NicholasAntoniadesEngineer/ventilator-control-system-prototype/Pictures and Videos/Ventilator demonstrator assembly.jpg

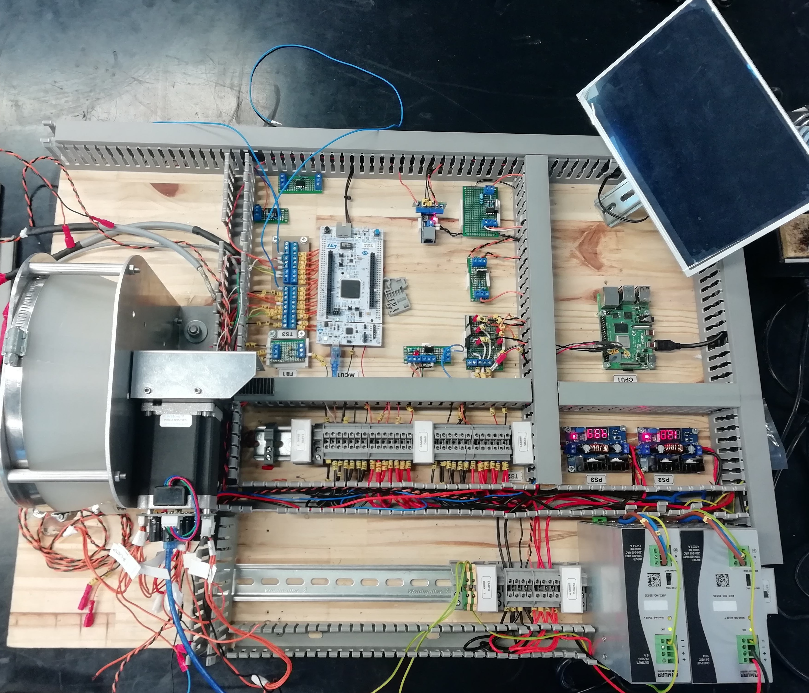
Pictures and Videos/Ventilator demonstrator assembly.jpg
