NicholasAntoniadesEngineer/ventilator-control-system-prototype/ventilator_cpap/CPAP Prototype BOM.xlsx

Item | Quantity | Brand | Supplier | Price per item | Part Number
Power
Double pole isolator | 1 | Schneider Electric | RS components | R 530.10 | A9S65240
PSU, 12v, 8.5A | 1 | Mean Well | RS components | R 398.85 | LRS-100-12
Buck Converter, 1.2v to 36v, 5A 200W | 1 | Micro robotics | Micro robotics | R 135.00 | XL4016
MCU and CPU
Nucleo-F439ZI | 1 | STM | Digi-Key | R 500.00 | 497-18153-ND
Raspberry Pi 4 Model B 8GB | 1 | Raspberry Pi | Micro robotics | R 1298.00 | PI4-8GB
Sensors and Actuators
XGZ Pressure Sensor,- 10kPa to +10kPa | 2 | Micro robotics | Micro robotics | R 139.00 | XGZP6847A010KPGPN
Solenoid diaphragm valve | 1 | Made in house | Micro robotics | R 132.00 | JF-1039B
Solenoid | 1 | Airtac | Micro robotics | R 153.00 | 2ACK-12V
Electronic circuits
Solenoid driving circuit | 1 | Made in house
Pressure sensor voltage divider | 1 | Made in house
HMI
LCD screen | 1 |  | Altron arrow | R 1910.30 | PH128800TDD4-ZFAD1
Push buttons | 2 | Micro robotics | Micro robotics | R 39.00 | PBS-33B
Potentiometer | 1 | Micro robotics | Micro robotics | R 22.00 | P135
 |  |  | Total: | R 5257.25
 |  |  | This excludes the cost of the piping and wiring
