NicholasAntoniadesEngineer/ventilator-control-system-prototype/Initial Prototype System/Schematic/Project Aether.kicad_pcb

## KiCad design Initial Prototype System/Schematic/Project Aether.kicad_pcb (2024-10-20, last stored version)

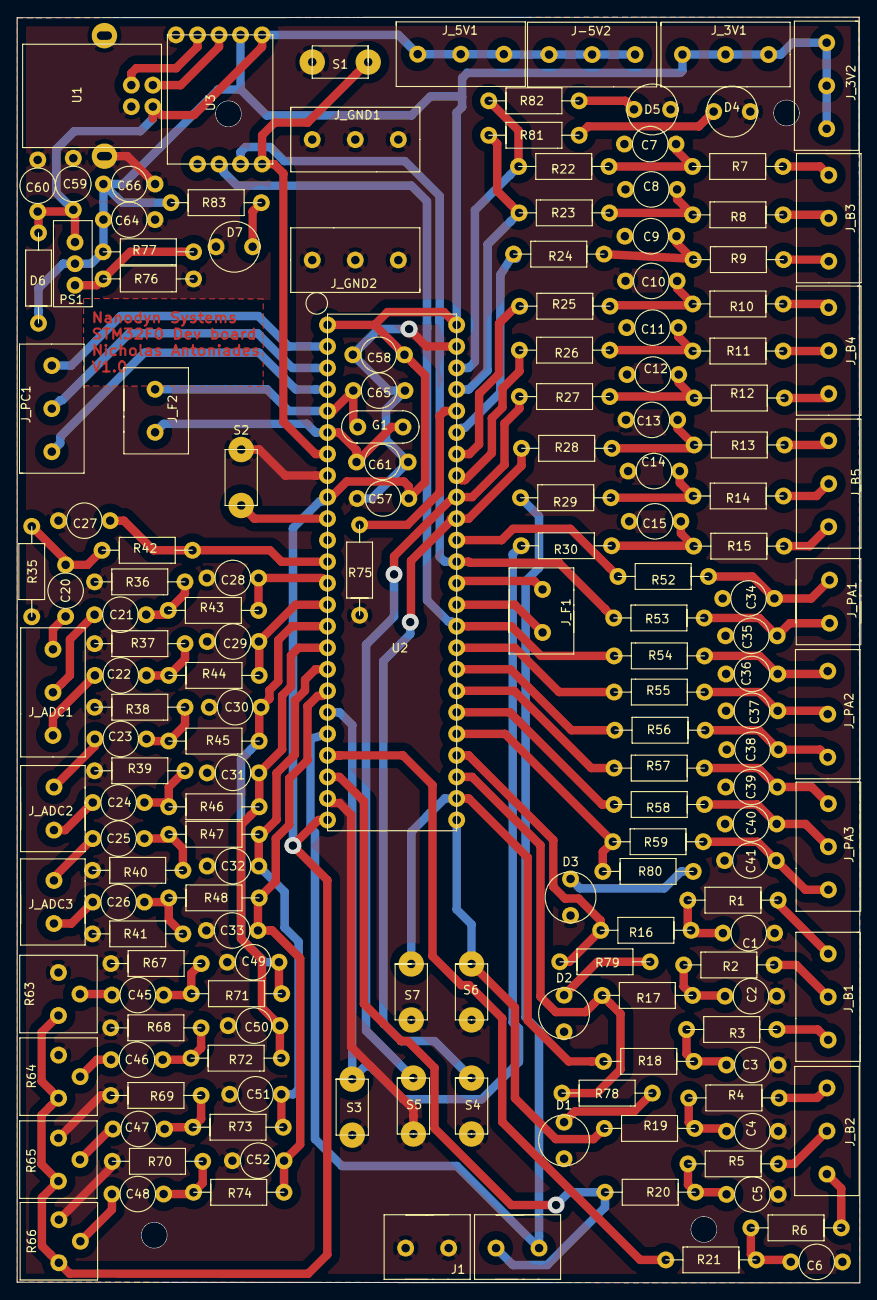
[picture p8: board Project Aether.kicad_pcb from above]

Board: 2 copper layers, 99.4 x 149.4 mm, 166 parts (0 on the bottom side), 112 nets.

Parts:
C1, C2, C3, C4, C5, C6, C7, C8, C9, C10, C11, C12, C13, C14, C15, C20, C21, C22, C23, C24, C25, C26, C27, C28, C29, C30, C31, C32, C33, C34, C35, C36, C37, C38, C39, C40, C41, C45, C46, C47, C48, C49, C50, C51, C52, C59, C60, C61, C64, C65, C66: C
C57: 1u; C
C58: 100n; C
D1, D2, D3, D4, D5, D7: LED
D6: Diode
G1: Oscillator
J1: MotorHeader; MotorHeaders
J-5V2: 3-pinTerminal; 3-pin Terminal
J_3V1, J_3V2, J_5V1: 3-pinTerminal; 3-pin Terminal
J_ADC1: 3-pinTerminal; 3-pin Terminal
J_ADC2, J_ADC3: 2-pinTerminal; 2-pin Terminal
J_B1, J_B2, J_B3, J_B4, J_B5: 3-pinTerminal; 3-pin Terminal
J_F1, J_F2: 2-pinTerminal; 2-pin Terminal
J_GND1, J_GND2: 3-pinTerminal; 3-pin Terminal
J_PA1: 2-pinTerminal; 2-pin Terminal
J_PA2, J_PA3: 3-pinTerminal; 3-pin Terminal
J_PC1: 3-pinTerminal; 3-pin Terminal
PS1: LM317
R1, R2, R3, R4, R5, R6, R7, R8, R9, R10, R11, R12, R13, R14, R15, R16, R17, R18, R19, R20, R21, R22, R23, R24, R25, R26, R27, R28, R29, R30, R35, R36, R37, R38, R39, R40, R41, R42, R43, R44, R45, R46, R47, R48, R52, R53, R54, R55, R56, R57, R58, R59, R67, R68, R69, R70, R71, R72, R73, R74, R75, R76, R77, R83: R
R63, R64, R65, R66: Potentiometer; Potentiometers
R78, R79, R80, R81, R82: 100; R
S1, S2, S3, S4, S5, S6, S7: Button; Mini Button
U1: 61729-0010BLF
U2: STM32F051C6; STM32F51C6_Header
U3: STM32F1-debugger; STM32F1_Debugger

Connections:
+3V3: C57.1, C58.1, C64.1, C66.1, D6.1, J_3V1.1, J_3V1.2, J_3V1.3, J_3V2.1, J_3V2.2, J_3V2.3, PS1.2, R63.3, R64.3, R65.3, R66.3, R77.1, R83.1, U2.1, U2.9, U2.24, U2.48, U3.2
+5V: C59.1, C60.2, D6.2, J-5V2.1, J-5V2.2, J-5V2.3, J_5V1.1, J_5V1.2, J_5V1.3, PS1.3, U1.1, U3.1
/ADC2: C27.1, R42.2, U2.12
/ADC3: C28.1, R43.2, U2.13
/ADC4: C29.1, R44.2, U2.14
/ADC5: C30.1, C49.1, R45.2, R71.2, U2.15
/ADC6: C31.1, C50.1, R46.2, R72.2, U2.16
/ADC7: C32.1, C51.1, R47.2, R73.2, U2.17
/ADC8: C33.1, C52.1, R48.2, R74.2, U2.18
/Limit: R56.2, U2.32
/NRST: S1.2, U2.7, U3.9
/PA0: S2.2, U2.10
/PA8: R59.2, R80.1, U2.29
/PA12: R55.2, U2.33
/PA13: R54.2, U2.34, U3.7
/PA14: R53.2, U2.37, U3.8
/PA15: R52.2, U2.38
/PB1: R30.2, S3.2, U2.19
/PB2: J1.1, R29.2, U2.20
/PB3: R28.2, S4.2, U2.39
/PB4: R27.2, S5.2, U2.40
/PB5: R26.2, U2.41
/PB6: R25.2, U2.42
/PB7: R24.2, U2.43
/PB8: R23.2, R81.1, U2.45
/PB9: R22.2, R82.1, U2.46
/PB10: R21.2, U2.21
/PB11: J1.2, R20.2, U2.22
/PB12: R19.2, S6.2, U2.25
/PB13: R18.2, S7.2, U2.26
/PB14: R17.2, R78.1, U2.27
/PB15: R16.2, R79.1, U2.28
/PC13: J_PC1.3, U2.2
/PC14: J_PC1.2, U2.3
/PC15: J_PC1.1, U2.4
/PF0: C65.1, G1.2, J_F2.2, U2.5
/PF1: C61.1, G1.1, J_F2.1, U2.6
/PF6: J_F1.2, U2.35
/PF7: J_F1.1, U2.36
/UART_RX: R58.2, U2.30
/UART_TX: R57.2, U2.31
GNDREF: C1.2, C2.2, C3.2, C4.2, C5.2, C6.2, C7.2, C8.2, C9.2, C10.2, C11.2, C12.2, C13.2, C14.2, C15.2, C27.2, C28.2, C29.2, C30.2, C31.2, C32.2, C33.2, C34.2, C35.2, C36.2, C37.2, C38.2, C39.2, C40.2, C41.2, C49.2, C50.2, C51.2, C52.2, C57.2, C58.2, C59.2, C60.1, C61.2, C64.2, C65.2, C66.2, D1.2, D2.2, D3.2, D4.2, D5.2, D7.2, J1.3, J1.4, J_GND1.1, J_GND1.2, J_GND1.3, J_GND2.1, J_GND2.2, J_GND2.3, R35.1, R36.1, R37.1, R38.1, R39.1, R40.1, R41.1, R63.1, R64.1, R65.1, R66.1, R67.1, R68.1, R69.1, R70.1, R75.1, R76.2, S1.1, S2.1, S3.1, S4.1, S5.1, S6.1, S7.1, U1.4, U1.5, U1.6, U2.8, U2.23, U2.47, U3.5
unnamed: C1.1, R1.2, R16.1
unnamed: C2.1, R2.2, R17.1
unnamed: C3.1, R3.2, R18.1
unnamed: C4.1, R4.2, R19.1
unnamed: C5.1, R5.2, R20.1
unnamed: C6.1, R6.2, R21.1
unnamed: C7.1, R7.2, R22.1
unnamed: C8.1, R8.2, R23.1
unnamed: C9.1, R9.2, R24.1
unnamed: C10.1, R10.2, R25.1
unnamed: C11.1, R11.2, R26.1
unnamed: C12.1, R12.2, R27.1
unnamed: C13.1, R13.2, R28.1
unnamed: C14.1, R14.2, R29.1
unnamed: C15.1, R15.2, R30.1
unnamed: C20.1, J_ADC1.1
unnamed: C20.2, R35.2, R42.1
unnamed: C21.1, J_ADC1.2
unnamed: C21.2, R36.2, R43.1
unnamed: C22.1, J_ADC1.3
unnamed: C22.2, R37.2, R44.1
unnamed: C23.1, J_ADC2.1
unnamed: C23.2, R38.2, R45.1
unnamed: C24.1, J_ADC2.2
unnamed: C24.2, R39.2, R46.1
unnamed: C25.1, J_ADC3.1
unnamed: C25.2, R40.2, R47.1
unnamed: C26.1, J_ADC3.2
unnamed: C26.2, R41.2, R48.1
unnamed: C34.1, J_PA1.1, R52.1
unnamed: C35.1, J_PA1.2, R53.1
unnamed: C36.1, J_PA2.1, R54.1
unnamed: C37.1, J_PA2.2, R55.1
unnamed: C38.1, J_PA2.3, R56.1
unnamed: C39.1, J_PA3.1, R57.1
unnamed: C40.1, J_PA3.2, R58.1
unnamed: C41.1, J_PA3.3, R59.1
unnamed: C45.1, R63.2
unnamed: C45.2, R67.2, R71.1
unnamed: C46.1, R64.2
unnamed: C46.2, R68.2, R72.1
unnamed: C47.1, R65.2
unnamed: C47.2, R69.2, R73.1
unnamed: C48.1, R66.2
unnamed: C48.2, R70.2, R74.1
unnamed: D1.1, R78.2
unnamed: D2.1, R79.2
unnamed: D3.1, R80.2
unnamed: D4.1, R81.2
unnamed: D5.1, R82.2
unnamed: D7.1, R83.2
unnamed: J_B1.1, R1.1
unnamed: J_B1.2, R2.1
unnamed: J_B1.3, R3.1
unnamed: J_B2.1, R4.1
unnamed: J_B2.2, R5.1
unnamed: J_B2.3, R6.1
unnamed: J_B3.1, R7.1
unnamed: J_B3.2, R8.1
unnamed: J_B3.3, R9.1
unnamed: J_B4.1, R10.1
unnamed: J_B4.2, R11.1
unnamed: J_B4.3, R12.1
unnamed: J_B5.1, R13.1
unnamed: J_B5.2, R14.1
unnamed: J_B5.3, R15.1
unnamed: PS1.1, R76.1, R77.2
unnamed: R75.2, U2.44
unnamed: U1.2, U3.3
unnamed: U1.3, U3.4
