NicholasAntoniadesEngineer/ventilator-control-system-prototype/ventilator_motor_control/main.c

/*
 ******************************************************************************
 * @file           : main.c
 * @brief          : Main application code for motor control in ventilator system
 * @date           : 2020
 * @author         : Nicholas Antoniades
 ******************************************************************************
 */

/* Includes */
#include "stm32f0xx.h"
#include "ventilator_state.h"
#include "ventilator_control.h"
#include "stm32_bsp.h"

static struct ventilator_state state;

static const struct ventilator_config config = 
{
    .motor = {
        .steps_per_rev = 1620,
        .gear_ratio = 4,
        .system_clock = 16000000
    },

    .control = {
        .bpm_max = 100,
        .pause_delay_ms = 180,
        .plateau_delay_ms = 100
    }
};

int main(void) 
{
    /* Initialize BSP */
    stm32_bsp_hal_init();
    
    /* Initialize ventilator state */
    ventilator_init(&state, &config);
    
    while (1) 
    {
        /* Handle button states */
        if (stm32_bsp_gpio_readpin(GPIOA, GPIO_PIN_0) == GPIO_PIN_RESET) 
        {
            /* Button released */
            sensor_read_and_send(&state.sensors);
        } 
        else 
        {
            /* Button pressed */
            handle_state_machine(&state);
        }
        
        /* Small delay to debounce */
        stm32_bsp_delay(10);
    }
    return 0;
}
