NicholasAntoniadesEngineer/ventilator-control-system-prototype/(commit log)

2021-08-17 Rename STM32f439ZIT6U Aether Light/.mxproject to STM32f439ZIT6U V/.mxproject
2021-08-17 Changes made
    [Aether Light BOM.xlsx]
2024-10-20 Cleaning up and reorganising code base
    [Aether Light BOM.xlsx]
2024-10-20 Removing old files
    [CPAP Prototype BOM.xlsx]
2024-10-20 Organise additional files
    [Project Aether.kicad_pcb, Project Aether.sch]
2024-11-02 cleaning up
    [Project Aether.kicad_pcb, Project Aether.sch]
2024-11-09 Cleaning and updating
    [CPAP Prototype BOM.xlsx]
2024-11-09 Refactor out motor control
2025-01-06 Rename folders
    [CPAP Prototype BOM.xlsx]
